HacksmithBogdan/Thrust-Tester-Rig/Stand.SLDASM

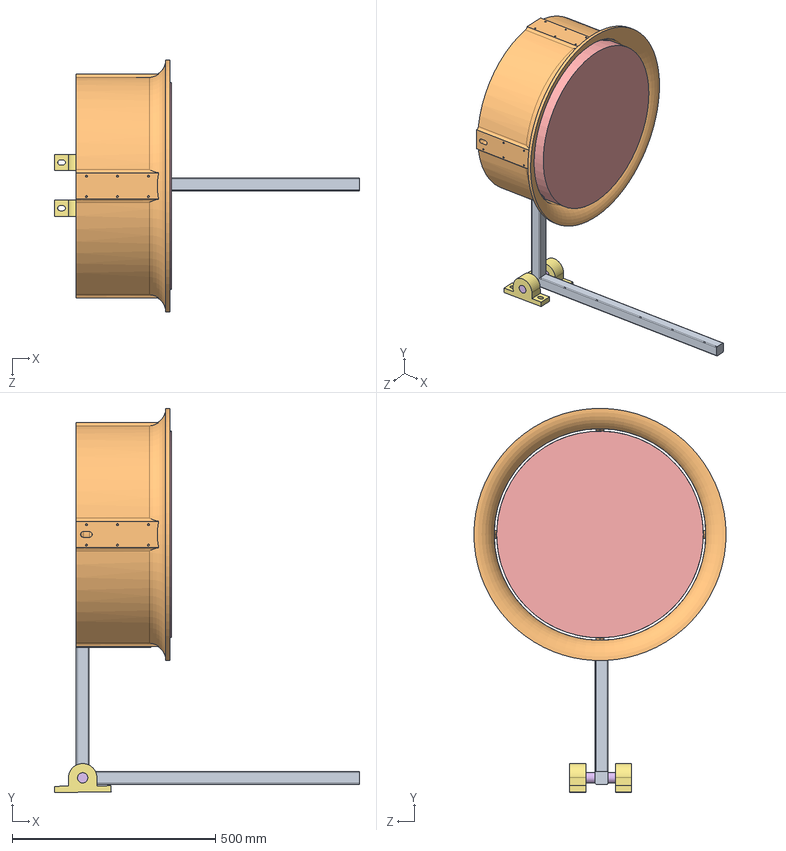
[picture p3: CAD file, 2026-10-23]
Stand.SLDASM
750.5 x 944.1 x 620.0 mm
Thrust Stand
Large EDF Duct-1
RotoMax 150cc-1
EDF prop 20x11-1
EDF Rotational Area
Shaft
Pillow Bearing x 2
