HacksmithBogdan/Thrust-Tester-Rig/Thrust Stand.SLDPRT

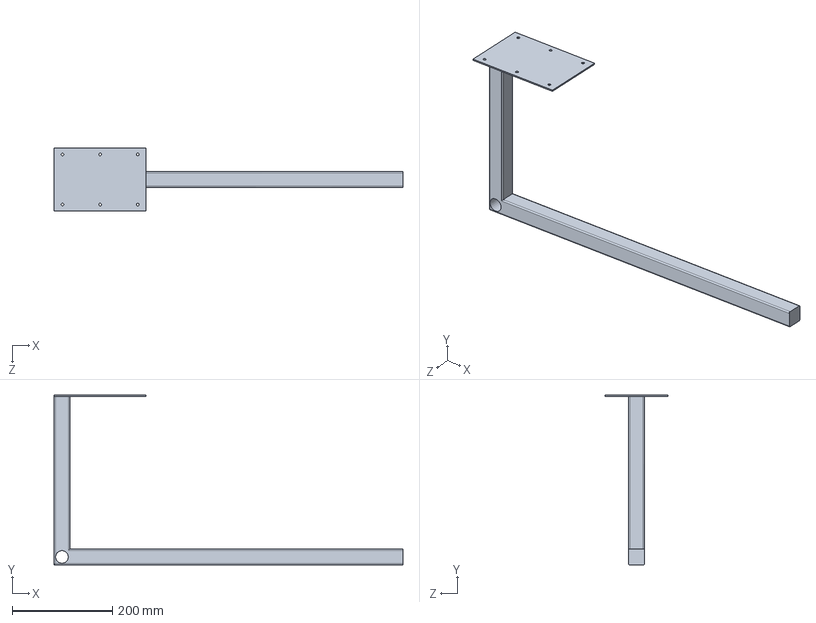
[picture p4: CAD file, 2026-10-23]
Thrust Stand.SLDPRT
696.7 x 339.1 x 125.0 mm
