HacksmithBogdan/Thrust-Tester-Rig/Shaft.SLDPRT

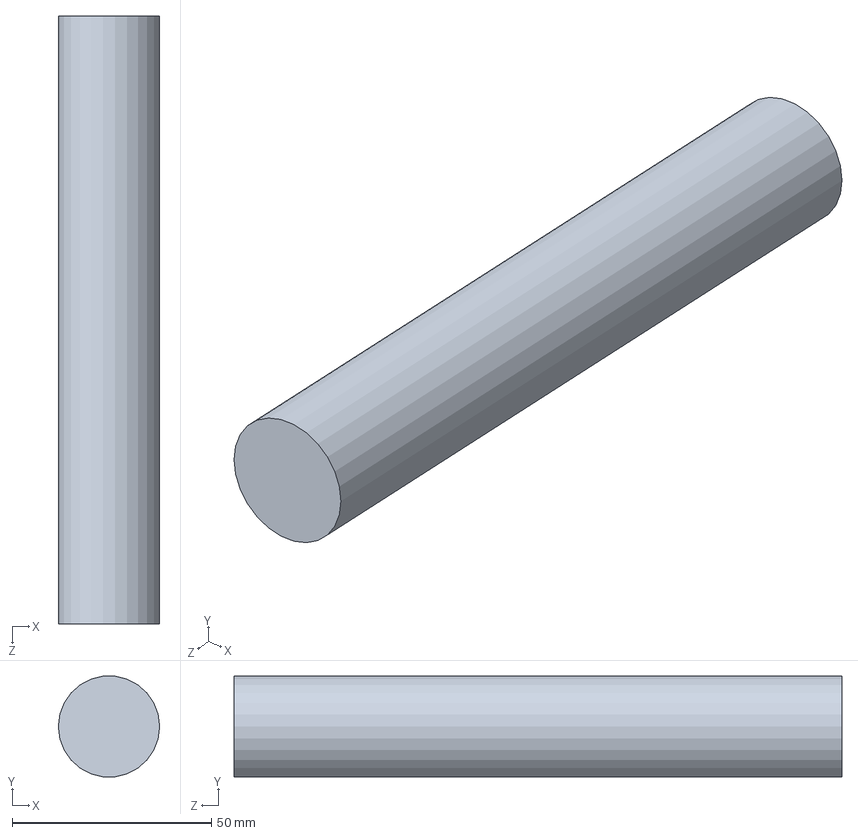
[picture p5: CAD file, 2026-10-23]
Shaft.SLDPRT
25.4 x 25.2 x 152.4 mm
