HacksmithBogdan/Thrust-Tester-Rig/Bearing.SLDPRT

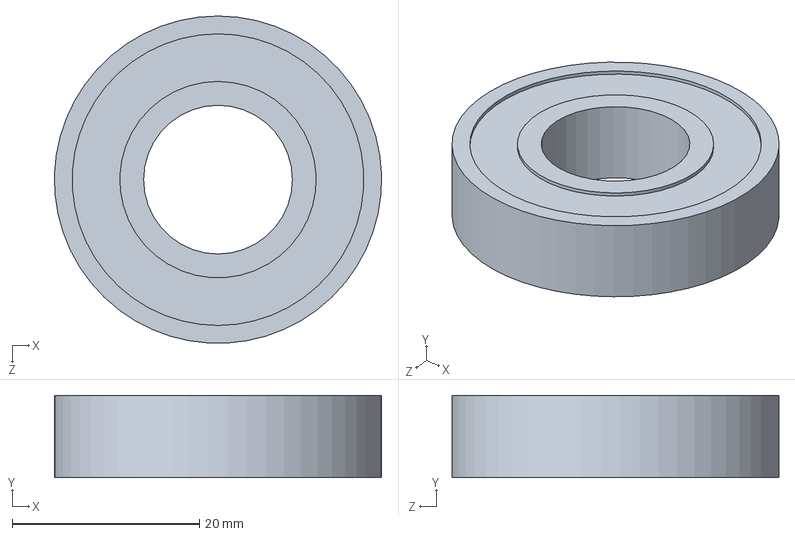
[picture p6: CAD file, 2026-10-23]
Bearing.SLDPRT
34.9 x 8.76 x 34.9 mm
