HacksmithBogdan/Thrust-Tester-Rig/Pillow Bearing.SLDPRT

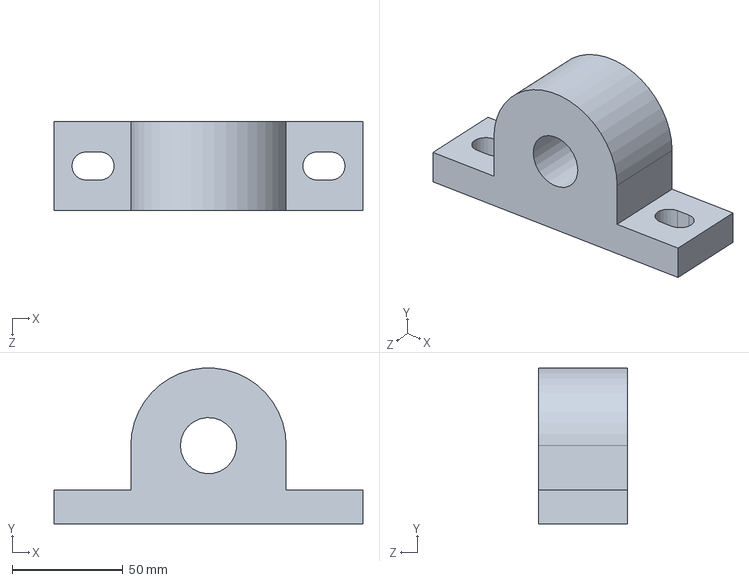
[picture p7: CAD file, 2026-10-23]
Pillow Bearing.SLDPRT
139.7 x 70.4 x 40.1 mm
