HacksmithBogdan/Thrust-Tester-Rig/Load Cell Mount.SLDPRT

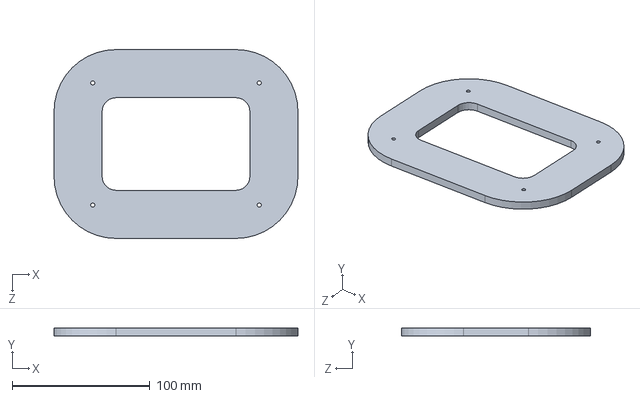
[picture p8: CAD file, 2026-10-23]
Load Cell Mount.SLDPRT
177.0 x 6.00 x 137.0 mm
