HacksmithBogdan/Thrust-Tester-Rig/(commit log)

2026-10-23 Archive original thrust tester rig project and document restoration
    [Bearing.SLDPRT, Load Cell Mount.SLDPRT, Pillow Bearing.SLDPRT, Shaft.SLDPRT, Stand.SLDASM, Thrust Stand.SLDPRT]
2026-10-25 Add ESP32-S3 USB host gateway and local thrust dashboard
    [partitions.csv]
2026-10-27 Port USB gateway to Touch LCD 2.8B with microSD logging
    [partitions.csv]
2026-10-27 Return restoration target to headless ESP32-S3 Zero
    [partitions.csv]
2026-10-27 Capture fresh HX711 samples with compact USB streaming and faster dashboard
